re-innovation/TTGO_EPaper/(threads)

Thread 1 (2021-01-20):

ESP32-Targz has changed the syntax

PCurd, 2021-01-20:
After the commit (https://github.com/tobozo/ESP32-targz/commit/a90d4ddc4073750988b40709ce1204c3917fcd07) ESP32-Targz has moved to an OO model where instead of calling gzExpander directly, in the new syntax you need to create a GzUnpacker object first. So instead of:

 ```
 // At this point we have got a file with the gzip data in SPIFFS
  // We need to decompress it to another location in SPIFFS
  if ( ! gzExpander(SPIFFS, "/stored.gz", SPIFFS, "/stored.txt") ) {
    Serial.printf("operation failed with return code #%d", tarGzGetError() );
    return false;
  }
```

It could be something like:

```
  // At this point we have got a file with the gzip data in SPIFFS
  // We need to decompress it to another location in SPIFFS

    GzUnpacker *GZUnpacker = new GzUnpacker();

    GZUnpacker->haltOnError( true ); // stop on fail (manual restart/reset required)
    GZUnpacker->setupFSCallbacks( targzTotalBytesFn, targzFreeBytesFn ); // prevent the partition from exploding, recommended
    GZUnpacker->setGzProgressCallback( BaseUnpacker::defaultProgressCallback ); // targzNullProgressCallback or defaultProgressCallback
    GZUnpacker->setLoggerCallback( BaseUnpacker::targzPrintLoggerCallback  );    // gz log verbosity

  if ( ! GZUnpacker->gzExpander(SPIFFS, "/stored.gz", SPIFFS, "/stored.txt") ) {
    Serial.printf("operation failed with return code #%d", GZUnpacker->tarGzGetError() );
    return false;
  }
```

I could raise this as a PR but I don't understand half the options above so you should probably make the decision how it should be done!
