re-innovation/TTGO_EPaper/TTGO_EINK_WifiManager_PUBLIC/Config.h

#pragma once


// General Function Libraries - Already installed in Arduino IDE
#include <Arduino.h>
#include <stdint.h>
#include <Millis.h>
#include <EEPROM.h>        // For writing values to the EEPROM

//Adafruit IO info
//https://io.adafruit.com/api/docs/mqtt.html#mqtt-connection-details
#define AIO_SERVER                         "io.adafruit.com" // direct
#define AIO_SERVERPORT                     1883  // 8883  // Use 8883 if at all possible!
#define AIO_USERNAME                       "***ENTER HERE***" // This is your Adafruit IO username
#define AIO_KEY                            "***ENTER HERE***" // This is your Adafruit IO Key
