re-innovation/TTGO_EPaper/TTGO_EINK_EXAMPLES/TTGO_EPAPER_EXAMPLES_PUBLIC/CE_Icons.h

#pragma once

#if defined(ESP8266) || defined(ESP32)
#include <pgmspace.h>
#else
#include <avr/pgmspace.h>
#endif

#ifdef WEATHER_EXAMPLE

const unsigned char gImage_sunny[350]  = {  /* 0X00,0X01,0X32,0X00,0X32,0X00, */
0XFF,0XFF,0XE0,0X01,0XFF,0XFF,0XC0,0XFF,0XFF,0XE0,0X01,0XFF,0XFF,0XC0,0XFF,0XFF,
0XF0,0X03,0XFF,0XFF,0XC0,0XFF,0XFF,0XF0,0X03,0XFF,0XFF,0XC0,0XFF,0XFF,0XF0,0X03,
0XFF,0XFF,0XC0,0XFF,0XFF,0XF8,0X07,0XFF,0XFF,0XC0,0XFF,0XFF,0XF8,0X07,0XFF,0XFF,
0XC0,0XFF,0XFF,0XF8,0X07,0XFF,0XFF,0XC0,0XFD,0XFF,0XF8,0X07,0XFF,0XEF,0XC0,0XF8,
0X7F,0XF8,0X07,0XFF,0X87,0XC0,0XF8,0X3F,0XFC,0X0F,0XFF,0X07,0XC0,0XF0,0X1F,0XFC,
0X0F,0XFE,0X03,0XC0,0XE0,0X0F,0XFC,0X0F,0XFC,0X01,0XC0,0XE0,0X07,0XFC,0X0F,0XF8,
0X01,0XC0,0XC0,0X03,0XFE,0X1F,0XF0,0X00,0XC0,0X80,0X01,0XFE,0X1F,0XE0,0X00,0X40,
0X80,0X00,0XFF,0XFF,0XC0,0X00,0X40,0X80,0X00,0X7F,0XFF,0X80,0X00,0XC0,0XF0,0X00,
0X3F,0XFF,0X00,0X07,0XC0,0XFC,0X00,0X7E,0X0F,0X80,0X1F,0XC0,0XFF,0XC0,0X78,0X07,
0X80,0XFF,0XC0,0XFF,0XF8,0XF0,0X03,0XC7,0XFF,0XC0,0XFF,0XFF,0XE0,0X01,0XFF,0XFF,
0XC0,0XFF,0XFF,0XE0,0X01,0XFF,0XFF,0XC0,0XFF,0XFF,0XE0,0X01,0XFF,0XFF,0XC0,0XFF,
0XFF,0XE0,0X01,0XFF,0XFF,0XC0,0XFF,0XFF,0XE0,0X01,0XFF,0XFF,0XC0,0XFF,0XFE,0XE0,
0X01,0XDF,0XFF,0XC0,0XFF,0XF0,0XF0,0X03,0XC3,0XFF,0XC0,0XFF,0X80,0X70,0X03,0X80,
0X7F,0XC0,0XFC,0X00,0X7C,0X0F,0X80,0X0F,0XC0,0XE0,0X00,0X3F,0XFF,0X00,0X03,0XC0,
0X80,0X00,0X7F,0XFF,0X80,0X00,0X40,0X80,0X00,0XFF,0XFF,0XC0,0X00,0X40,0XC0,0X01,
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
    0xcf, 0xff, 0x80, 0x00, 0x00, 0x7f, 0xff, 0xf0, 0x00, 0x0f, 0xf1, 0x31, 0xf0, 
    0x83, 0xff, 0x00, 0x00, 0x00, 0xff, 0xff, 0xf3, 0xe6, 0x07, 0xf1, 0x99, 0xf0, 
    0x31, 0xfe, 0x00, 0x00, 0x04, 0xff, 0xff, 0xe7, 0xf2, 0x03, 0xf9, 0x88, 0xf0, 
    0xff, 0xfc, 0x00, 0x00, 0x0c, 0xff, 0xff, 0xcf, 0xf8, 0x01, 0xf8, 0xcc, 0xf0, 
    0xff, 0xfc, 0x00, 0x00, 0x58, 0xff, 0xff, 0xc3, 0xf8, 0x00, 0xfc, 0x44, 0xf0, 
    0xff, 0xf8, 0x00, 0x00, 0x99, 0xff, 0xff, 0x83, 0xf0, 0x00, 0x7e, 0x65, 0xf0, 
    0xff, 0xf0, 0x00, 0x00, 0x99, 0xff, 0xff, 0x33, 0xe0, 0x40, 0x3e, 0x07, 0xf0, 
    0xff, 0xf3, 0x00, 0x00, 0x39, 0xff, 0xfe, 0x3b, 0xe0, 0x00, 0x3f, 0x07, 0xf0, 
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
};
