re-innovation/TTGO_EPaper/TTGO_EINK_EXAMPLES/TTGO_EPAPER_EXAMPLES_PUBLIC/wifi_local.h

#pragma once

#include "Config.h"
// WiFimanager
#include <WiFiManager.h> // https://github.com/tzapu/WiFiManager

void setup_wifi(bool my_reset_settings_flag = false);
void stopWiFi();
#ifdef WEATHER_EXAMPLE

void saveParamsCallback();
#endif
