re-innovation/TTGO_EPaper/(commit log)

2020-07-09 Updated Enclosure Files
2020-11-11 Large update of code and enclosure files
2020-12-18 Updated from bugs sent to me
    Removed Millis() (not needed redundant library in quote machine code).
    Sorted out issue with not cleaing display on Wifi setup.
    [CE_Icons.h, Config.h, board_def.h, display.cpp, display.h, utilities.cpp, utilities.h]
2023-03-02 Updated both driver versions. Added comments to code.
2026-05-01 updated code
    draw grpah correct way around from left to right,
    [TTGO_EPAPER_EXAMPLES_PUBLIC.ino, display.cpp]
